log2win/A11039Case/1Bms/BmsCaseLid.stl

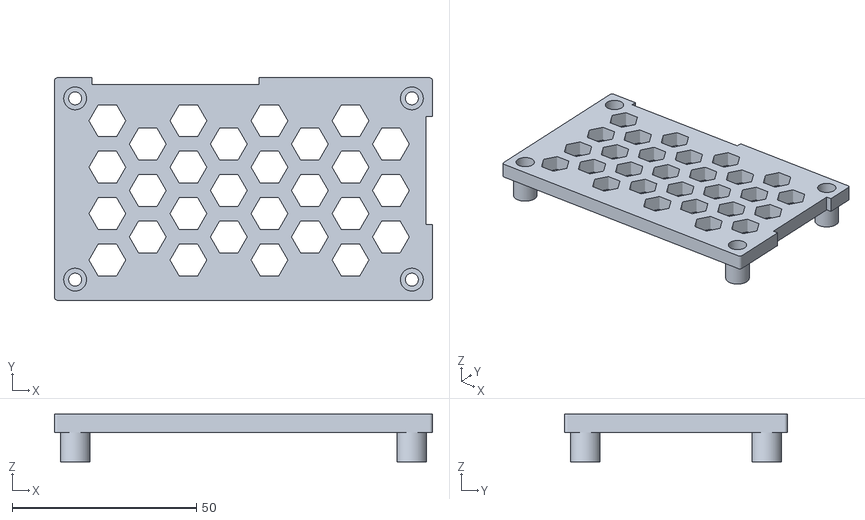
[picture p3: CAD file, 2026-10-11]
1Bms/BmsCaseLid.stl
102.6 x 60.4 x 13.0
