log2win/A11039Case/2Bms/2BmsCaseBody.stl

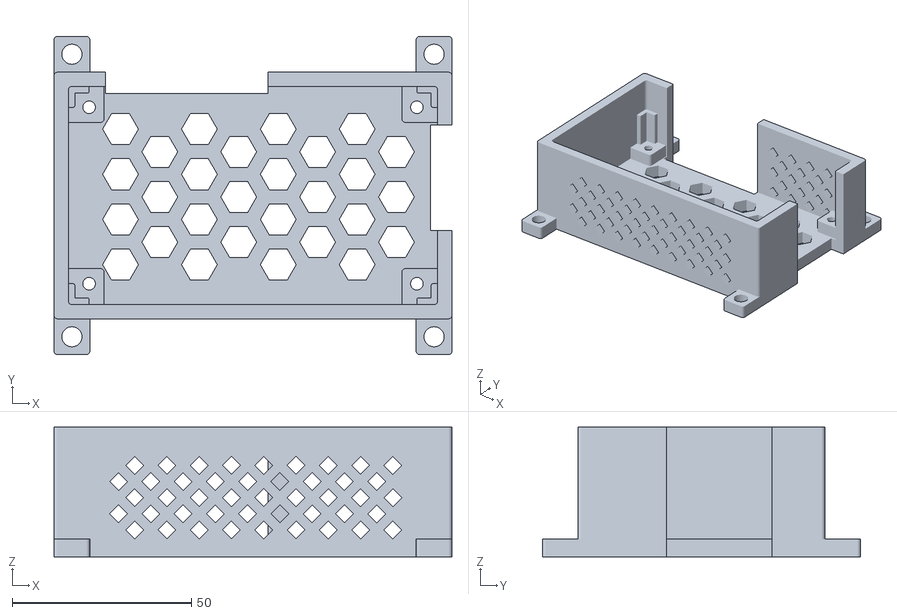
[picture p4: CAD file, 2026-10-11]
2Bms/2BmsCaseBody.stl
111.0 x 88.8 x 36.2
