log2win/A11039Case/BmsCase.FCStd

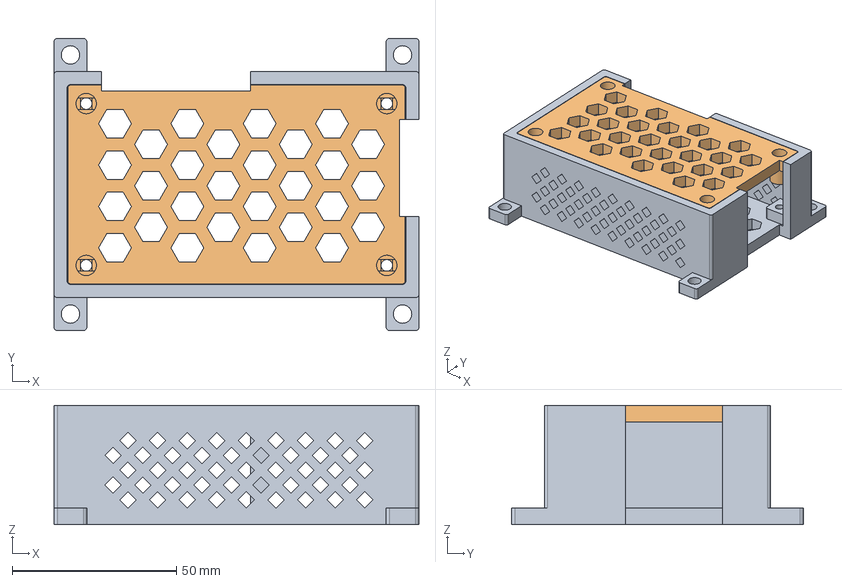
[picture p5: CAD file, 2026-10-11]
BmsCase.FCStd
111.0 x 88.8 x 36.2 mm
Lid
