log2win/A11039Case/1Bms/1BmsCaseBody.stl

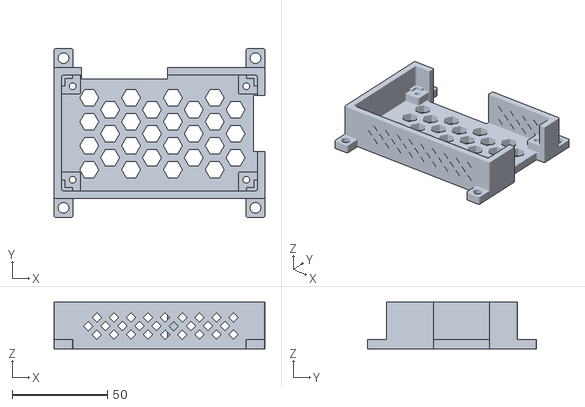
[picture p6: CAD file, 2026-10-11]
1Bms/1BmsCaseBody.stl
111.0 x 88.8 x 24.6
